icibici/hardware-files/eeg4-bom.xls

Bill of Materials: Farnell 1 (arrived 20/07/16)
Ref. | Farnell order code | Mfg. | Part No. | Description | unit price | quantity | total price | comments | URL/comments
C1 | 2494265 | Murata | GRM219R72A472KA01D | capacitor, 4.7nF | £0.0084 | 120 | £1.01 | 100 Vdc | http://uk.farnell.com/murata/grm219r72a472ka01d/cap-mlcc-x7r-4700pf-100v-0805/dp/2494265
C2 | 2497048 | Walsin | 0805X106K100CT | capacitor, 10µF | £0.0350 | 120 | £4.20 | 10 Vdc | http://uk.farnell.com/walsin/0805x106k100ct/capacitor-mlcc-x5r-10uf-10v-0805/dp/2497048
C3 | 2496944RL | Walsin | 0805B104K500CT | capacitor, 100nF | £0.0077 | 480 | £3.70 |  | http://uk.farnell.com/walsin/0805b104k500ct/capacitor-mlcc-x7r-0-1uf-50v-0805/dp/2496944RL
C4 | 2497003 | Walsin | 0805F474Z250CT | capacitor, 470nF | £0.0248 | 120 | £2.98 |  | http://uk.farnell.com/walsin/0805f474z250ct/capacitor-mlcc-y5v-0-47uf-25v/dp/2497003
C5 | 2442786 | Kemet | C1210C107M8PACTU | capacitor, 100µF | £0.5550 | 120 | £66.60 | 10 Vdc | http://uk.farnell.com/kemet/c1210c107m8pactu/cap-mlcc-x5r-100uf-10v-1210/dp/2442786
C6 |  | -- | -- | capacitor, 100nF |  |  |  | see C3, above
C7 | 2470433RL | Murata | GCM216R71H102KA37D | capacitor, 1nF | £0.0061 | 240 | £1.46 |  | http://uk.farnell.com/murata/gcm216r71h102ka37d/cap-mlcc-x7r-1000pf-50v-0805/dp/2470433RL
C8 |  | -- | -- | capacitor, 1nF |  |  |  | see C7, above
C9 |  | -- | -- | capacitor, 100nF |  |  |  | see C3, above
C10 |  | -- | -- | capacitor, 100nF |  |  |  | see C3, above
J1 | 2453367 | Fairchild | MMBF4393 | JFET | £0.34 | 120 | £40.80 |  | http://uk.farnell.com/fairchild-semiconductor/mmbf4393/jfet-n-channel-30v-sot-23-3/dp/2453367
R1 | 9333150 | Multicomp | MC01W08051390R | resistor, 390 | £0.0016 | 240 | £0.38 |  | http://uk.farnell.com/multicomp/mc01w08051390r/res-thick-film-390r-1-0-1w-0805/dp/9333150
R2 | 9332405RL | Multicomp | MC01W08051100K | resistor, 100K | £0.002 | 240 | £0.36 |  | http://uk.farnell.com/multicomp/mc01w08051100k/res-thick-film-100k-1-0-1w-0805/dp/9332405RL
R3 |  | -- | -- | resistor, 100K |  |  |  | see R2, above
R5 | 9332618 | Multicomp | MC01W0805115K | resistor, 15K | £0.002 | 240 | £0.38 |  | http://uk.farnell.com/multicomp/mc01w0805115k/res-thick-film-15k-1-0-1w-0805/dp/9332618
R6 |  | -- | -- | resistor, 15K |  |  |  | see R5, above
R7 | 9332413 | Multicomp | MC01W080511M | resistor, 1M | £0.002 | 120 | £0.19 |  | http://uk.farnell.com/multicomp/mc01w080511m/res-thick-film-1m-1-0-1w-0805/dp/9332413
R8 | 9332812 | Multicomp | MC01W080512K2 | resistor, 2.2K | £0.002 | 240 | £0.36 |  | http://uk.farnell.com/multicomp/mc01w080512k2/res-thick-film-2k2-1-0-1w-0805/dp/9332812
R9 | 9332766 | Multicomp | MC01W080512K | resistor, 2K | £0.002 | 120 | £0.18 |  | http://uk.farnell.com/multicomp/mc01w080512k/res-thick-film-2k-1-0-1w-0805/dp/9332766
R10 |  | -- | -- | resistor, 2.2K |  |  |  | see R8, above
R11 | 9332391 | Multicomp | MC01W0805110K | resistor, 10K | £0.0016 | 240 | £0.38 |  | http://uk.farnell.com/multicomp/mc01w0805110k/res-thick-film-10k-1-0-1w-0805/dp/9332391
R12 |  | -- | -- | resistor, 390 |  |  |  | see R1, above
R13 | 2447601 | Multicomp | MCWR08X2003FTL | resistor, 200K | £0.0049 | 120 | £0.59 |  | http://uk.farnell.com/multicomp/mcwr08x2003ftl/res-thick-film-200kohm-1-0-125w/dp/2447601
R14 |  | -- | -- | resistor, 10K |  |  |  | see R11, above
U1 | 9426183 | Analog Devices | AD620ARZ | op-amp | £3.43 | 120 | £411.60 |  | http://uk.farnell.com/analog-devices/ad620arz/ic-instr-amp-120khz-130db-8soic/dp/9426183
U2 | 2531395 | ON Semiconductor | MC33174DR2G | quad op-amp | £0.53 | 120 | £63.60 |  | http://uk.farnell.com/on-semiconductor/mc33174dr2g/opamp-1-8mhz-2-1v-us-0-005v-soic14/dp/2531395
U3 |  |  |  | integrated circuit |  |  |  | integrated with U2, above
U4 |  |  |  | integrated circuit |  |  |  | integrated with U2, above
U5 |  |  |  | integrated circuit |  |  |  | integrated with U2, above
battery | 5019333 | Greencell | GP1604G-10 | 10 x 9v battery | £5.57 | 12 | £66.84
audio connector | 1267377 | pro-signal | MJ-2135 | 5 x 3.5mm 4 pole socket | £1.68 | 24 | £40.32 |  | http://uk.farnell.com/pro-signal/mj-2135/connector-rca-jack-3-5mm-tht-4way/dp/1267377
battery plug | 1702642 | Keystone | 593 | 9V neg terminal | £0.38 | 120 | £45.60 |  | http://uk.farnell.com/keystone/593/battery-pcb-contact/dp/1702642
battery plug | 1650706 | Keystone | 594 | 9V pos terminal | £0.28 | 120 | £33.60 |  | http://uk.farnell.com/keystone/594/battery-pcb-pos-contact/dp/1650706
electrode screw terminals | 2509527 | Weidmuller | 1234550000 | electrode screw terminals | £0.30 | 120 | £36.00
 |  |  |  |  |  |  | £1005.51 | some prices slightly other than as per original spec; 2x JFET ordered by accident, returned | total cost from this supplier (inc. VAT)
 |  |  |  |  |  |  | £8.38 |  | unit cost from this supplier (inc. VAT)
Bill of Materials: Amazon 1 (arrived 23/07/16)
Ref. | order code | Mfg. | Part No. | Description | unit price | quantity | total price | comments | URL/comments
alcohol swabs |  |  |  | 100 pack swabs | £2.29 | 3 | £6.87 |  | https://www.amazon.co.uk/Alcotip-Isopropyl-Alcohol-Pre-Injection-Swabs/dp/B008ET7R2S
baggies |  |  |  | 100 x 3.5" x 4.5" bags | £0.96 | 2 | £1.92 | for Ten20 | https://www.amazon.co.uk/Grip-Seal-Bags-Strong-Reusable/dp/B0026DGN00
 |  |  |  |  |  |  | £8.79 |  | total cost from this supplier (inc. VAT)
 |  |  |  |  |  |  | £0.07 |  | unit cost from this supplier (inc. VAT)
Bill of Materials: Amazon 2 (arrived 23/07/16)
Ref. | order code | Mfg. | Part No. | Description | unit price | quantity | total price | comments | URL/comments
printer labels |  |  |  | 50 sheets x 8 labels | £3.89 | 1 | £3.89 |  | https://www.amazon.co.uk/gp/product/B00IJZP3H8/ref=od_aui_detailpages00?ie=UTF8&psc=1
 |  |  |  |  |  |  | £3.89 |  | total cost from this supplier (inc. VAT)
 |  |  |  |  |  |  | £0.03 |  | unit cost from this supplier (inc. VAT)
Bill of Materials: Farnell 2 (arrived 21/07/16)
Ref. | Farnell order code | Mfg. | Part No. | Description | unit price | quantity | total price | comments | URL/comments
bag | 1503128 | Multicomp | 010-0014 | 100 x (8" x 6") anti-static bag | £6.89 | 2 | £13.78 |  | http://uk.farnell.com/multicomp/010-0014/static-shielding-bag-6x8-pk100/dp/1503128
croc clip | 1101094 | Deltron Components | 303-0000-01 | 15mm croc clip | £0.33 | 120 | £39.60 |  | http://uk.farnell.com/deltron-components/303-0000-01/crocodile-clip-15mm-steel-5a/dp/1101094
jumper wires | 2396146 | Multicomp | MCBBJ65 |  | £2.67 | 2 | £5.34 |  | http://uk.farnell.com/multicomp/mcbbj65/jumper-wire-assortment-65pcs/dp/2396146
 |  |  |  |  |  |  | £69.89 |  | total cost from this order (inc. VAT)
 |  |  |  |  |  |  | £0.58 |  | unit cost from this order (inc. VAT)
Bill of Materials: Aliexpress 1 (arrived 22/07/16)
Ref. | order code | Mfg. | Part No. | Description | unit price | quantity | total price | comments | URL/comments
audio cable |  |  |  | 20 x 3.5mm 4 pole male-male cable |  | 6 | £109.36 |  | http://www.aliexpress.com/item/20pc-lot-4-Pole-3-5mm-Male-to-Male-Stereo-Headphone-Audio-Extension-Cord-Cable-Gold/32320446955.html
 |  |  |  |  |  |  | £4.90 |  | import duties
 |  |  |  |  |  |  | £114.26 |  | total cost from this supplier (inc. VAT)
 |  |  |  |  |  |  | £0.95 |  | unit cost from this supplier (inc. VAT)
Bill of Materials: Aliexpress 2 (tracking number EV937468670CN)
Ref. | order code | Mfg. | Part No. | Description | unit price | quantity | total price | comments | URL/comments
swimming cap |  |  |  |  | £1.22 | 120 | £199.13 |  | http://www.aliexpress.com/item/Fashion-Durable-Sporty-Rubber-Swim-Cap-Swimming-HatHY-3998/32263420064.html
 |  |  |  |  |  |  | £30.58 |  | import VAT & clearance fee
 |  |  |  |  |  |  | £229.71 |  | total cost from this supplier (inc. VAT)
 |  |  |  |  |  |  | £1.91 |  | unit cost from this supplier (inc. VAT)
Bill of Materials: Makro (arrived 23/07/16)
Ref. | order code | Mfg. | Part No. | Description | unit price | quantity | total price | comments | URL/comments
foil shield |  |  |  | foil (45cm x 90m) | £10.79 | 2 | £21.58 | ex VAT | http://www.makro.co.uk/chefs-larder-catering-foil-45cm-x-90m-1s.html
 |  |  |  |  |  |  | £4.99 |  | shipping
 |  |  |  |  |  |  | £26.57 |  | total cost from this supplier (inc. VAT)
 |  |  |  |  |  |  | £0.22 |  | unit cost from this supplier (inc. VAT)
Bill of Materials: Unimed Electrodes (arrived 25/07/16)
Ref. | Unimed order code | Mfg. | Part No. | Description | unit price | quantity | total price |  | URL/comments
electrodes | DEEG-10A | Unimed | DEEG-10A | 25 x 100cm electrodes | £8.95 | 15 | £134.25 |  | http://unimed-electrodes.co.uk/Disposable-EEG-Electrode-100cm-Lead-TP-Connector-25set/329
skin prep | 10-20-D | Weaver & Co |  | 12 x 228g Ten20 tubs | £106.00 | 1 | £106.00 | need 1oz tubes | http://unimed-electrodes.co.uk/Ten20-EEG-Conductive-paste-Discounted-Pack-228gm-(8oz)-tub/98
 |  |  |  |  |  |  | £12.00 |  | shipping
 |  |  |  |  |  |  | £302.70 |  | total cost from this supplier (inc. VAT)
 |  |  |  |  |  |  | £2.52 |  | unit cost from this supplier (inc. VAT)
Bill of Materials: hackvana (collected 02/08/16)
 |  |  |  | 120 boards |  |  | £146.90 |  | as per 19/07/16 invoice
 |  |  |  |  |  |  | £24.00 |  | import duties
 |  |  |  |  |  |  | £170.90 |  | total cost from this supplier (inc VAT)
 |  |  |  |  |  |  | £1.42 |  | unit cost from this supplier (inc. VAT)
Bill of Materials: Somerset Solders (collected 01/08/16)
solder | MR-P053 |  |  | 863 SAC305 No Clean Solder Paste Type 3 250g jar |  |  | £29.50 |  | http://www.somersetsolders.com/qualitek-863-lead-free-solder-paste/p311
tweezers | MR-T195 |  |  | Stainless Steel Tweezer 108 - Precision Tools for SMD |  |  | £9.95 |  | http://www.somersetsolders.com/stainless-steel-tweezer-108-for-smd-components/p510
tweezers |  |  |  | 3x Stainless Steel Tweezer 7SA - Precision Tools |  |  | £11.55 |  | http://www.somersetsolders.com/stainless-steel-curved-tweezers-7sa/p158
 |  |  |  |  |  |  | £8.50 |  | shipping
 |  |  |  |  |  |  | £11.90 |  | VAT
 |  |  |  |  |  |  | £71.40 |  | total cost from this supplier (inc VAT)
 |  |  |  |  |  |  | £0.60 |  | unit cost from this supplier (inc. VAT)
 |  |  |  |  |  |  | £2003.62 |  | total cost from all suppliers (inc. VAT)
 |  |  |  |  |  |  | £16.70 |  | unit cost from all suppliers (inc. VAT)
notes
R4 is only in the schematic; it represents the human user
C9, C10 not on the schematic; added by Nick to decouple supply
