icibici/hardware-files/asc Files/eeg4.pdf

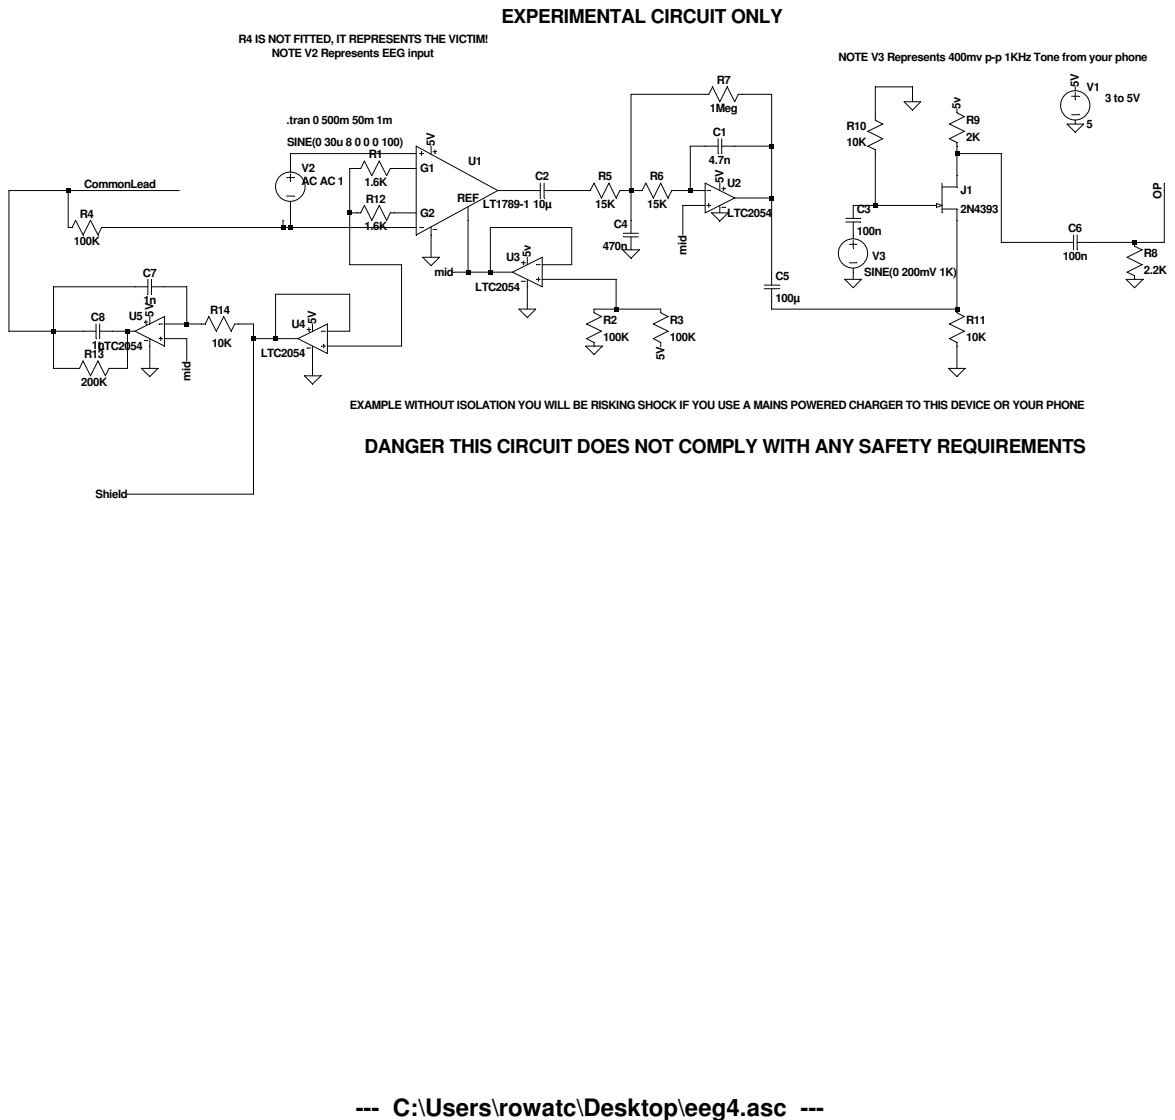
[picture p1: page 1]

R4 IS NOT FITTED, IT REPRESENTS THE VICTIM!

EXAMPLE WITHOUT ISOLATION YOU WILL BE RISKING SHOCK IF YOU USE A MAINS POWERED CHARGER TO THIS DEVICE OR YOUR PHONE

DANGER THIS CIRCUIT DOES NOT COMPLY WITH ANY SAFETY REQUIREMENTS

--- C:\Users\rowatc\Desktop\eeg4.asc ---
