icibici/hardware-files/asc Files/eeg1 TESTING.asc

C1: cap; 10µ
C2: cap; 10µ
C3: cap; 100n
C4: cap; 4.7n
C5: cap; 22µ
C6: cap; 100n
C7: cap; 10µ
J1: njf; 2N4393
R1: res; 3.3K
R2: res; 100K
R3: res; 100K
R5: res; 100R
R6: res; 15K
R7: res; 1MEG
R8: res; 2.2K
R9: res; 2K
R10: res; 10K
R11: res; 10K
R12: res; 100K
U1: LT1789-1
U2: LTC2054
U3: LTC2054
V1: voltage; 5
V2: voltage; SINE(0 100mV 8 0 0 0 100); AC AC 1
V3: voltage; SINE(0 200mV 1K)
Named nets: 0, 5V, OP, mid, 5v, CommonLead
.tran 0 500m 50m 1m
DANGER THIS CIRCUIT DOES NOT COMPLY WITH ANY SAFETY REQUIREMENTS
EXPERIMENTAL CIRCUIT ONLY
EXAMPLE WITHOUT ISOLATION YOU WILL BE RISKING SHOCK IF YOU USE A MAINS POWERED CHARGER TO THIS DEVICE OR YOUR PHONE
NOTE V3 Represents 400mv p-p 1KHz Tone from your phone
3 to 5V
THIS IS HOW TO CONNECT A GROUNDED SIGNAL GENERATOR FOR TESTING THE CIRCUIT.
