icibici/hardware-files/opto-isolation-design-preliminary/eeg5-opto-isolation.asc

C1: cap; 4.7n
C2: cap; 10µ
C3: cap; 100n
C4: cap; 470n
C6: cap; 100n
C7: cap; 1n
C8: cap; 1n
J1: njf; 2N4393
R1: res; 1.6K
R2: res; 100K
R3: res; 100K
R4: res; 100K
R5: res; 15K
R6: res; 15K
R7: res; 1Meg
R8: res; 2.2K
R9: res; 2K
R10: res; 10K
R11: res; 10K
R12: res; 1.6K
R13: res; 200K
R14: res; 10K
U1: LT1789-1
U2: LTC2054
U3: LTC2054
U4: LTC2054
U5: LTC2054
V1: voltage; 5
V2: voltage; SINE(0 30u 8 0 0 0 100); AC AC 1
V3: voltage; SINE(0 200mV 1K)
Named nets: 0, 5V, OP, mid, 5v, CommonLead, Shield
;tran 0 20000m 50m 1m
DANGER THIS CIRCUIT DOES NOT COMPLY WITH ANY SAFETY REQUIREMENTS
EXPERIMENTAL CIRCUIT ONLY
EXAMPLE WITHOUT ISOLATION YOU WILL BE RISKING SHOCK IF YOU USE A MAINS POWERED CHARGER TO THIS DEVICE OR YOUR PHONE
NOTE V2 Represents EEG input
NOTE V3 Represents 400mv p-p 1KHz Tone from your phone
R4 IS NOT FITTED, IT REPRESENTS THE VICTIM!
3 to 5V
.ac lin 10000 20000m 50m
