icibici/hardware-files/asc Files/eeg1.asc

C1: cap; 1µ
C2: cap; 10µ
C3: cap; 100n
C4: cap; 47n
C5: cap; 10µ
C6: cap; 220n
J1: njf; 2N4393
R1: res; 2K
R2: res; 100K
R3: res; 100K
R4: res; 10K
R6: res; 15K
R7: res; 1MEG
R8: res; 1000
R9: res; 2K
R10: res; 10K
R11: res; 10K
U1: LT1789-1
U2: LTC2054
U3: LTC2054
V1: voltage; 5
V2: voltage; SINE(0 80u 10 0 0 0 100); AC AC 1
V3: voltage; SINE(0 200mV 1K)
Named nets: 0, 5V, OP, mid, 5v, CommonLead
.tran 0 500m 0 1m
DANGER THIS CIRCUIT DOES NOT COMPLY WITH ANY SAFETY REQUIREMENTS
EXPERIMENTAL CIRCUIT ONLY
EXAMPLE WITHOUT ISOLATION YOU WILL BE RISKING SHOCK IF YOU USE A MAINS POWERED CHARGER TO THIS DEVICE OR YOUR PHONE
NOTE V2 Represents EEG input
NOTE V3 Represents 1vp-p 1KHz Tone from your phone
R4 IS NOT FITTED, IT REPRESENTS THE VICTIM!
