icibici/hardware-files/(list of files, drawings)

Other design files:
diptrace/eeg4.dch
diptrace/eeg.dip
