icibici/hardware-files/(commit log)

2023-09-14 BOM file uploaded
    [eeg4-bom.xls]
2023-09-14 diptrace files uploaded
    [eeg.dip, eeg4.dch]
2023-09-14 gerber files uploaded
    [eeg.back_v2.gbl, eeg.backmask_v2.gbs, eeg.backpaste_v2.gbp, eeg.backsilk_v2.gbo, eeg.front_v2.gtl, eeg.frontmask_v2.gts, eeg.frontpaste_v2.gtp, eeg.frontsilk_v2.gto]
2023-09-14 Rename eeg2.brd to EAGLE files/eeg2.brd
    [eeg2.brd]
